jconrow00/IOT-Alarm-Clock/thumbnail_IMG_6282.jpg

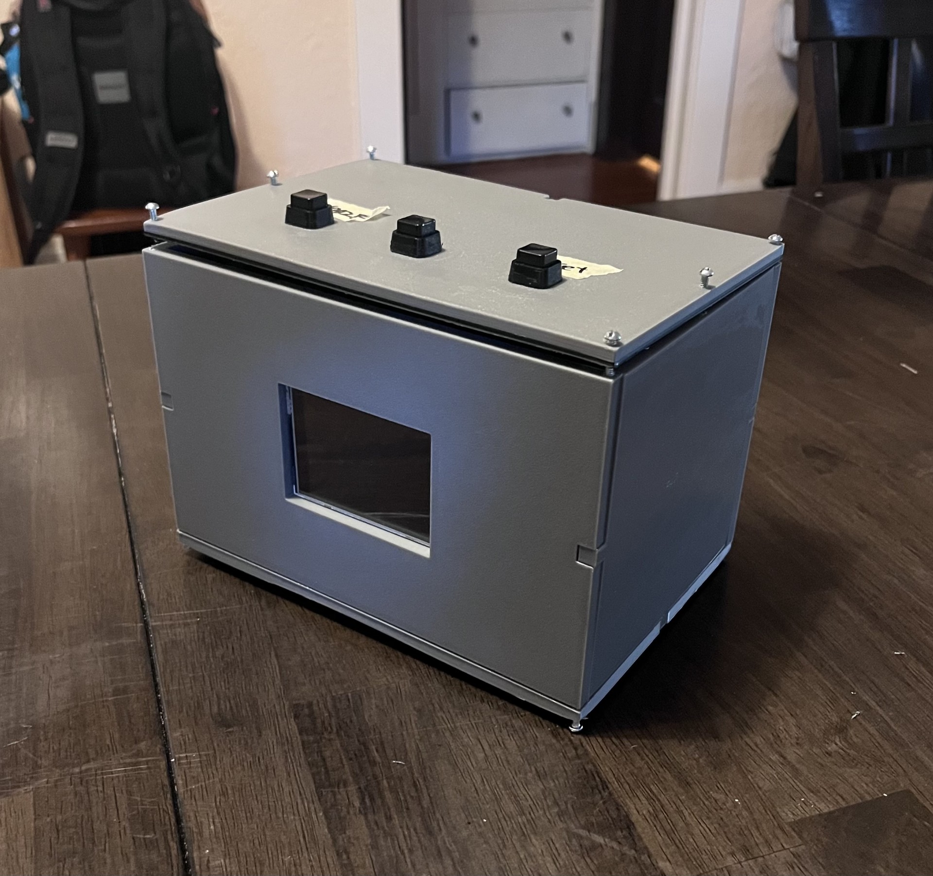
thumbnail_IMG_6282.jpg
