jconrow00/IOT-Alarm-Clock/Draft Image.png

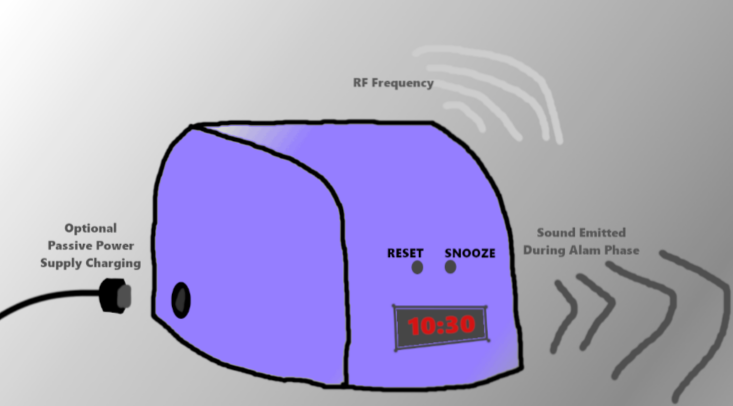
Draft Image.png
