jconrow00/IOT-Alarm-Clock/Website Interface/Screenshot from 2024-02-18 02-17-51.png

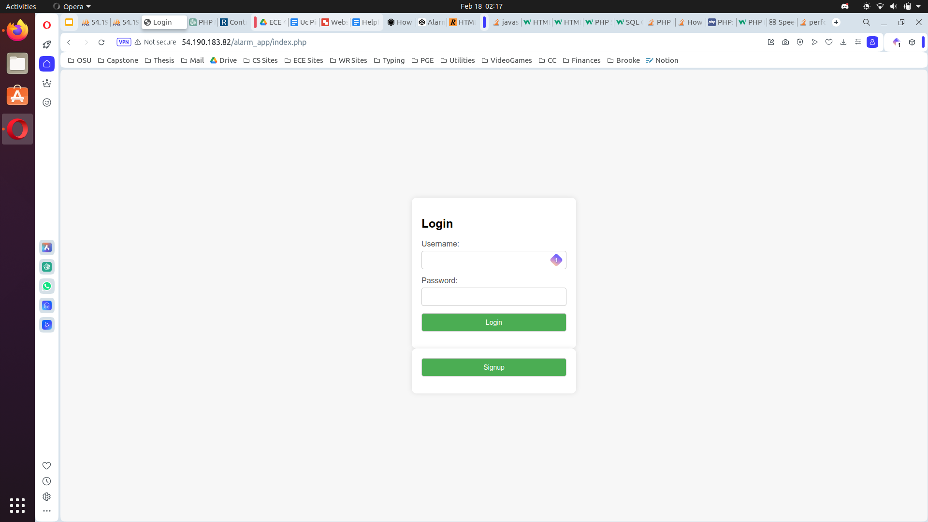
Website Interface/Screenshot from 2024-02-18 02-17-51.png
