jconrow00/IOT-Alarm-Clock/Website Interface/Screenshot from 2024-02-18 02-17-57.png

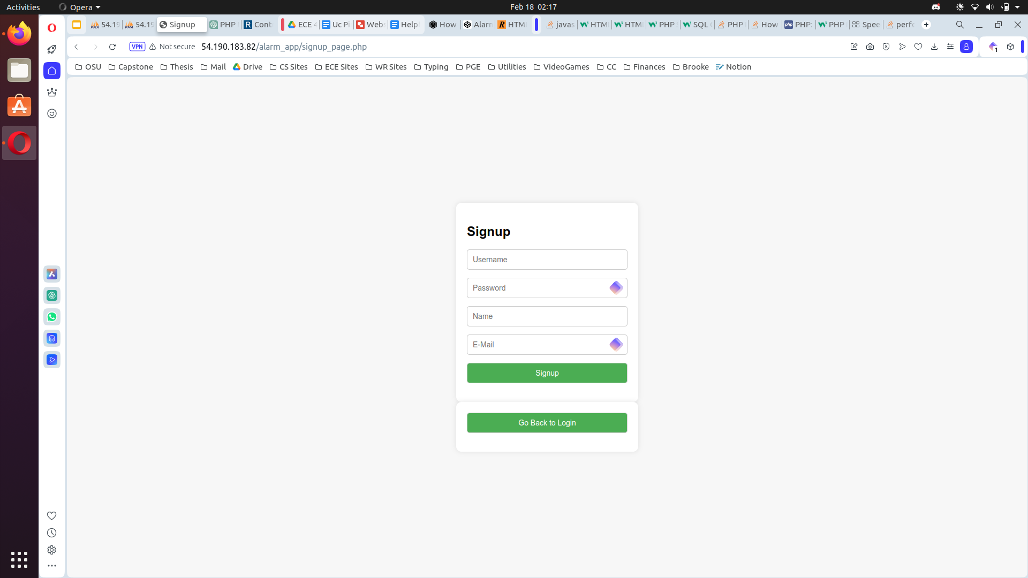
Website Interface/Screenshot from 2024-02-18 02-17-57.png
