jconrow00/IOT-Alarm-Clock/Tech Demo/ECE 441 - Tech Demo Order.pdf

ECE 441 - Sr Design

Tech Demo Order

Professor Heer

11/2/23

Joseph Conrow

SCHEMATIC LAYOUT

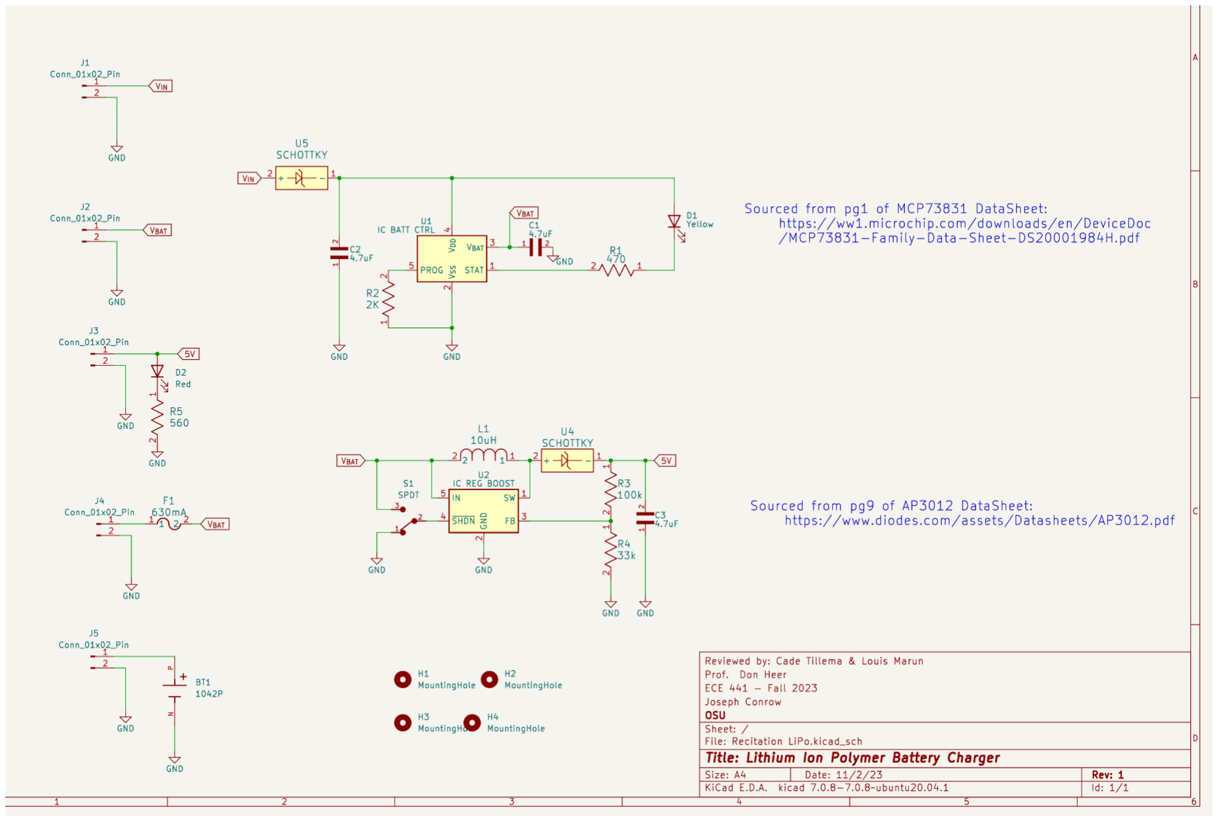
[picture p31: figure]
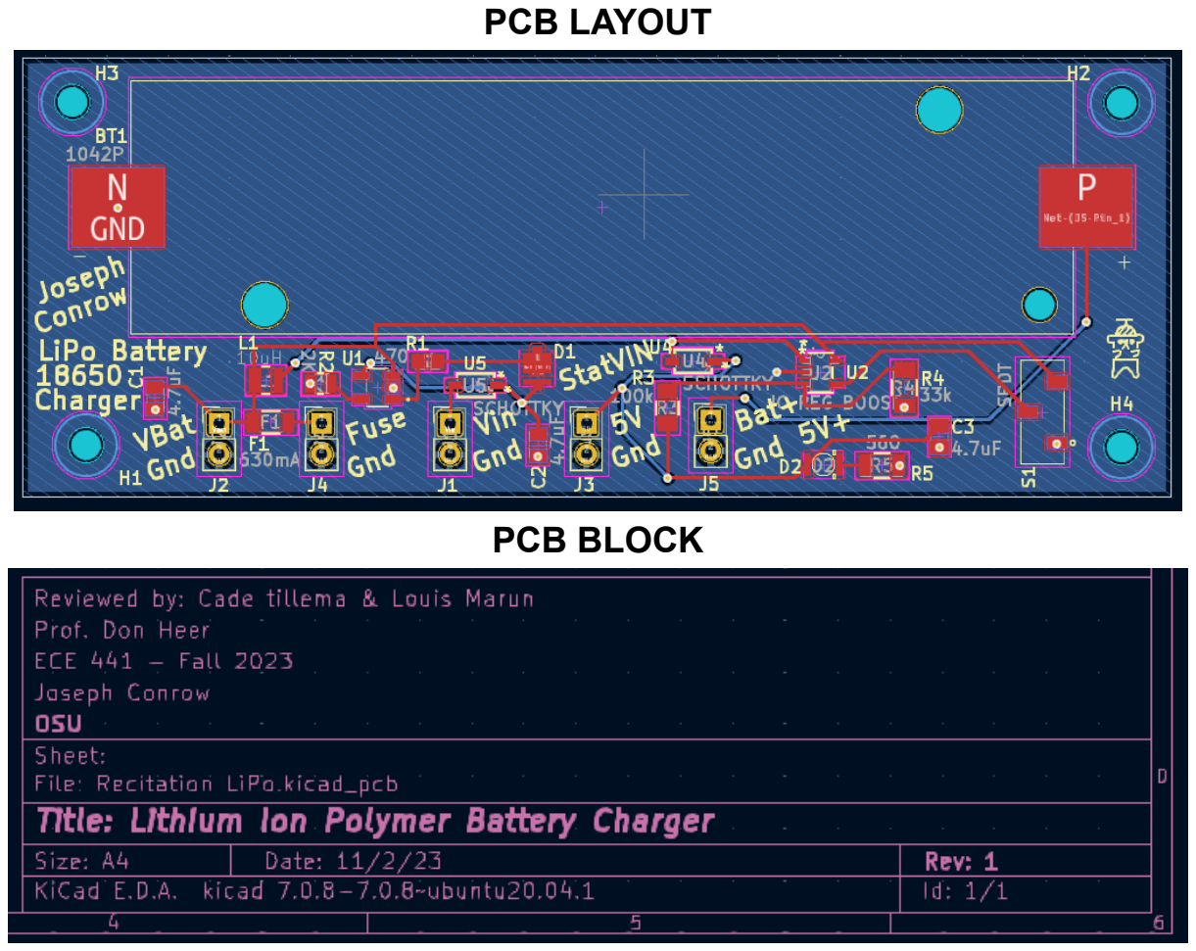
[picture p32: page 3]

PCB LAYOUT

PCB BLOCK

OSH PARK RECIEPT

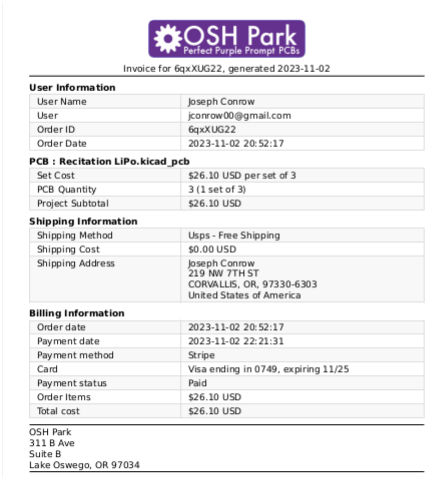
[picture p33: figure]
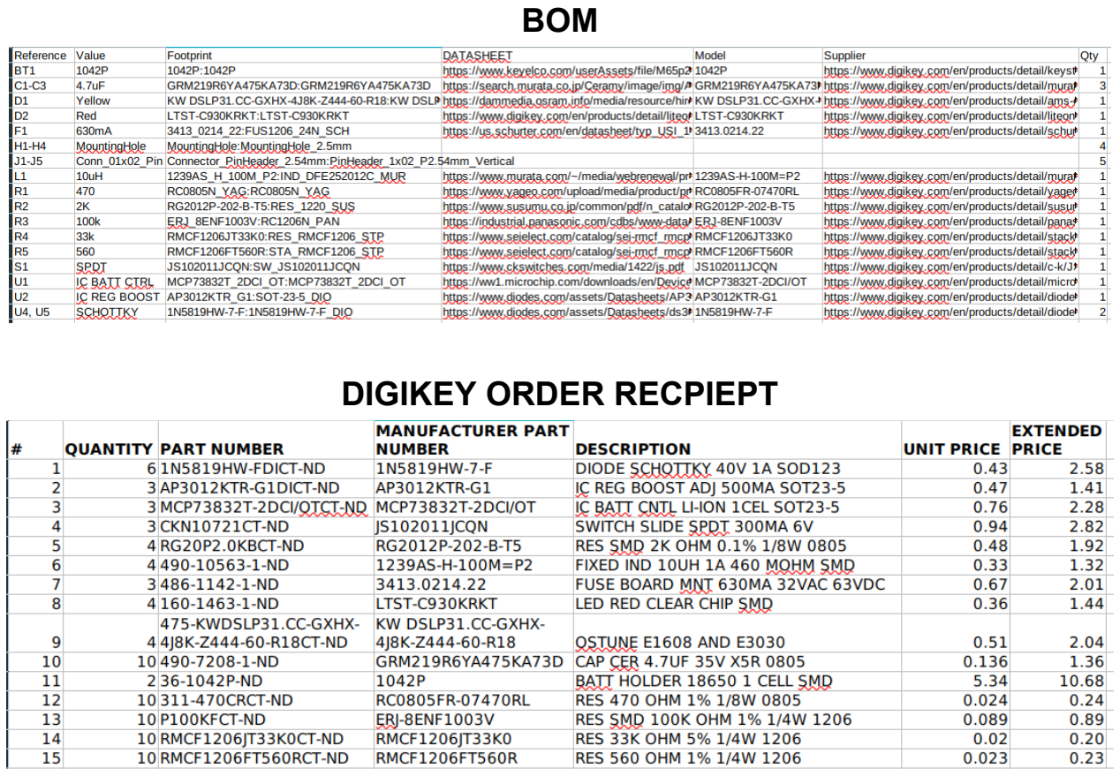
[picture p34: page 5]

BOM

DIGIKEY ORDER RECPIEPT
