jconrow00/IOT-Alarm-Clock/Tech Demo/Digikey_Order(11_2_23).xlsx

# | QUANTITY | PART NUMBER | MANUFACTURER PART NUMBER | DESCRIPTION | CUSTOMER REFERENCE | BACKORDER | UNIT PRICE | EXTENDED PRICE
1 | 6 | 1N5819HW-FDICT-ND | 1N5819HW-7-F | DIODE SCHOTTKY 40V 1A SOD123 |  | 0 | 0.43 | 2.58
2 | 3 | AP3012KTR-G1DICT-ND | AP3012KTR-G1 | IC REG BOOST ADJ 500MA SOT23-5 |  | 0 | 0.47 | 1.41
3 | 3 | MCP73832T-2DCI/OTCT-ND | MCP73832T-2DCI/OT | IC BATT CNTL LI-ION 1CEL SOT23-5 |  | 0 | 0.76 | 2.28
4 | 3 | CKN10721CT-ND | JS102011JCQN | SWITCH SLIDE SPDT 300MA 6V |  | 0 | 0.94 | 2.82
5 | 4 | RG20P2.0KBCT-ND | RG2012P-202-B-T5 | RES SMD 2K OHM 0.1% 1/8W 0805 |  | 0 | 0.48 | 1.92
6 | 4 | 490-10563-1-ND | 1239AS-H-100M=P2 | FIXED IND 10UH 1A 460 MOHM SMD |  | 0 | 0.33 | 1.32
7 | 3 | 486-1142-1-ND | 3413.0214.22 | FUSE BOARD MNT 630MA 32VAC 63VDC |  | 0 | 0.67 | 2.01
8 | 4 | 160-1463-1-ND | LTST-C930KRKT | LED RED CLEAR CHIP SMD |  | 0 | 0.36 | 1.44
9 | 4 | 475-KWDSLP31.CC-GXHX-4J8K-Z444-60-R18CT-ND | KW DSLP31.CC-GXHX-4J8K-Z444-60-R18 | OSTUNE E1608 AND E3030 |  | 0 | 0.51 | 2.04
10 | 10 | 490-7208-1-ND | GRM219R6YA475KA73D | CAP CER 4.7UF 35V X5R 0805 |  | 0 | 0.136 | 1.36
11 | 2 | 36-1042P-ND | 1042P | BATT HOLDER 18650 1 CELL SMD |  | 0 | 5.34 | 10.68
12 | 10 | 311-470CRCT-ND | RC0805FR-07470RL | RES 470 OHM 1% 1/8W 0805 |  | 0 | 0.024 | 0.24
13 | 10 | P100KFCT-ND | ERJ-8ENF1003V | RES SMD 100K OHM 1% 1/4W 1206 |  | 0 | 0.089 | 0.89
14 | 10 | RMCF1206JT33K0CT-ND | RMCF1206JT33K0 | RES 33K OHM 5% 1/4W 1206 |  | 0 | 0.02 | 0.20
15 | 10 | RMCF1206FT560RCT-ND | RMCF1206FT560R | RES 560 OHM 1% 1/4W 1206 |  | 0 | 0.023 | 0.23
