jconrow00/IOT-Alarm-Clock/Tech Demo/Recitation LiPo/Recitation LiPo.csv

# | Reference | Qty | Value | Footprint | DNP
1 | U1 | 1 | MCP73832-2-OT | Package_TO_SOT_SMD:SOT-23-5
