jconrow00/IOT-Alarm-Clock/Tech Demo/Recitation LiPo/Recitation LiPo.kicad_pcb

## KiCad design Tech Demo/Recitation LiPo/Recitation LiPo.kicad_pcb (2024-03-09)

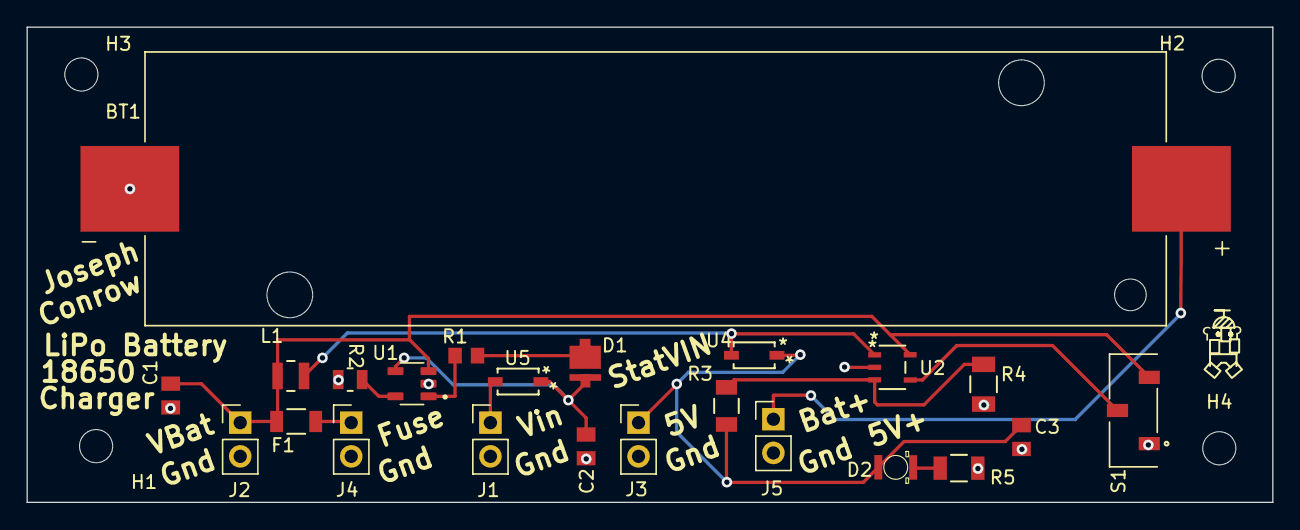
[picture p38: board Recitation LiPo.kicad_pcb from above]

Board: 2 copper layers, 94.0 x 35.9 mm, 27 parts (0 on the bottom side), 14 nets.

Parts:
BT1: 1042P
C1, C2, C3: 4.7uF; GRM219R6YA475KA73D
D1: Yellow; KW DSLP31.CC-GXHX-4J8K-Z444-60-R18
D2: Red; LTST-C930KRKT
F1: 630mA; FUS1206_24N_SCH
H1, H2, H3, H4: MountingHole; MountingHole_2.5mm
J1, J2, J3, J4, J5: Conn_01x02_Pin; PinHeader_1x02_P2.54mm_Vertical
L1: 10uH; IND_DFE252012C_MUR
R1: 470; RC0805N_YAG
R2: 2K; RES_1220_SUS
R3: 100k; RC1206N_PAN
R4: 33k; RES_RMCF1206_STP
R5: 560; STA_RMCF1206_STP
S1: SPDT; SW_JS102011JCQN
U1: IC BATT CTRL; MCP73832T_2DCI_OT
U2: IC REG BOOST; SOT-23-5_DIO
U4, U5: SCHOTTKY; 1N5819HW-7-F_DIO

Connections:
5V: C3.2, D2.2 (A), J3.1, R3.1, U4.1 (-)
GND: BT1.N, C1.2, C2.1, C3.1, J1.2, J2.2, J3.2, J4.2, J5.2, R2.1, R4.2, R5.2, S1.1, U1.2 (V_{SS}), U2.2 (GND)
unnamed: C2.2, D1.2 (A), U1.4 (V_{DD}), U5.1 (-)
unnamed: D1.1 (K), R1.1
unnamed: D2.1 (K), R5.1
unnamed: F1.1, J4.1
unnamed: BT1.P, J5.1
unnamed: R2.2, U1.5 (PROG)
unnamed: R1.2, U1.1 (STAT)
unnamed: R3.2, R4.1, U2.3 (FB)
unnamed: L1.1, U2.1 (SW), U4.2 (+)
unnamed: S1.2, U2.4 (~SHDN)
V_{BAT}: C1.1, F1.2, J2.1, L1.2, S1.3, U1.3 (V_{BAT}), U2.5 (IN)
V_{IN}: J1.1, U5.2 (+)
